soundslikefrank/eduquencer/hardware/README.md

# Eduquencer pcb schematic and design

## TODO

### Path to PCB prototype
- [ ] Finish the schematic
  - [x] Wire up rpi
  - [x] Add circuits for clock and reset
  - [x] Add debug header for flashing the rpi
  - [x] Add all the trigger jacks (+circuit around them, there might be some more resistors needed?)
  - [x] Add test-points for all i2c and SPI
  - [x] Check all GND in analog parts and change to GNDA (cv-in?)
  - [x] Annotate all parts
  - [x] Assign footprints (all footprints should be the kicad handsolder ones)
  - [ ] Add LED circuits for CV in (op-amps)
  - [ ] Adjust DAC opamp resistor for proper range (+add DAC out jack)
- [ ] Preliminary layout with all components (only footprint placement)
- [ ] Decide on a name
- [ ] Decide which jacks to use
- [ ] Do the final layout

## Preliminary BOM (per board)
- 1x RPI Pico (3,90)
- 3x https://www.digikey.de/de/products/detail/epcos-tdk-electronics/B72500D0160H060/1589537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 (1,5 @ 100)
- 1x GET AT JLC https://www.digikey.de/en/products/detail/texas-instruments/LM1117MP-5-0-NOPB/363590 (1,3 @ 25)
- 1x https://www.digikey.de/en/products/detail/analog-devices-inc/ADP150AUJZ-3-0-R7/2207488 (1 @ 25)
- 2x https://www.digikey.de/en/products/detail/microchip-technology/MCP23018-E-SS/1999506 (1,5 @ 25)
- 1x https://www.digikey.de/en/products/detail/texas-instruments/DAC80501MDGSR/11308813 (we probably want to get more) (5,6 @ 10)
- 2x 22u electrolytic cap (~0,5 total?)
- 9x XZM2CRK45WT-9 (red)
- 10x: XZDGK45WT-9 (green)
- 16x switches (~16 total?)
- 1x https://www.digikey.de/en/products/detail/texas-instruments/TL074CD/277422 (1 @ 25)
- 1x GET AT JLCPCB https://www.digikey.de/en/products/detail/microchip-technology/MCP6002-E-MS/683195 (0,4 @ 25)
- 1x https://www.digikey.com.au/en/products/detail/texas-instruments/OPA172IDR/4695363 (2,1 @ 25)
- 1x https://www.digikey.de/en/products/detail/texas-instruments/LM4040DIM3-10-0-NOPB/305141 (0,6 @ 25)
- 1x https://www.digikey.de/en/products/detail/texas-instruments/LM4040DIM3-5-0-NOPB/305140 (0,6 @ 25)
- 1x https://www.digikey.de/en/products/detail/panjit-international-inc/MMBT3904W-R1-00001/14660622 (0,15 @ 10)
- 3x GET AT JLC https://www.digikey.de/en/products/detail/diodes-incorporated/1N5819HWQ-7-F/10294862
- 1x GET AT JLC https://www.digikey.de/en/products/detail/panjit-international-inc/1N4148W-R1-00001/14660400
- 11x Thonkiconn (0,25 - I have ~300)
- 2x https://www.thonk.co.uk/shop/short-trimmer-pots/ B100K (0,8)

### LEDs
- MCP capabilities: 25mA sink per pin, 400mA total
- RPI capabilities: 3V3 is the main 3.3V supply to RP2040 and its I/O, generated by the on-board SMPS. This pin can be used to power external circuitry (maximum output current will depend on RP2040 load and VSYS voltage, it is recommended to keep the load on this pin less than 300mA).
- Step/channel LEDs:
  - Green: XZDGK45WT-9; 1.4mA@560Ω@3v3
  - Red: XZM2CRK45WT-9; 6.3mA@220Ω@3v3
