soundslikefrank/eduquencer/design/footprint/.svg2shenzhen-cache/images/B.Cu_layer2.png

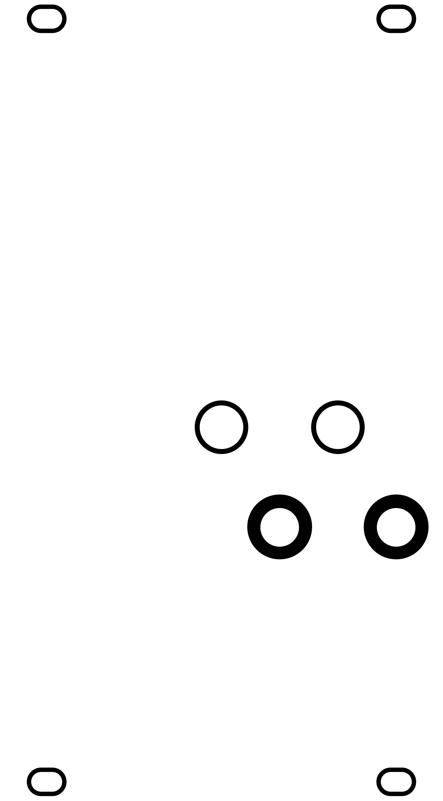
design/footprint/.svg2shenzhen-cache/images/B.Cu_layer2.png
