soundslikefrank/eduquencer/design/footprint/.svg2shenzhen-cache/images/B.Mask_layer1.png

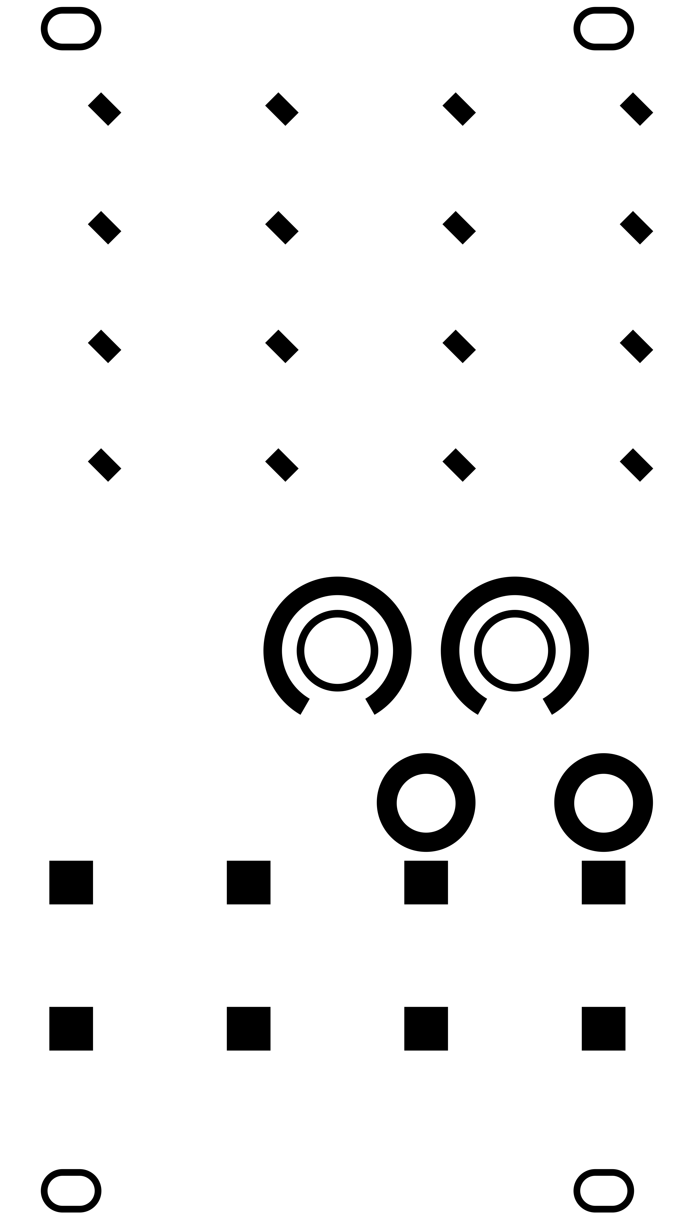
design/footprint/.svg2shenzhen-cache/images/B.Mask_layer1.png
