soundslikefrank/eduquencer/design/footprint/.svg2shenzhen-cache/images/Eco1.User_g74.png

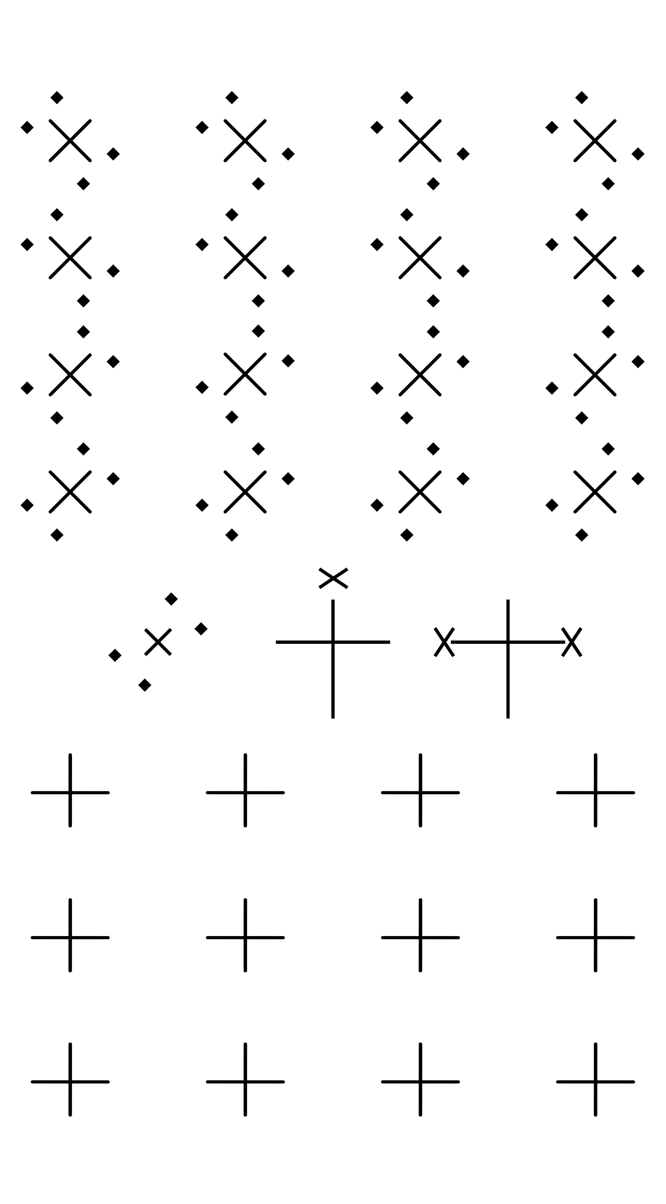
design/footprint/.svg2shenzhen-cache/images/Eco1.User_g74.png
