soundslikefrank/eduquencer/design/footprint/.svg2shenzhen-cache/images/F.Cu_g21.png

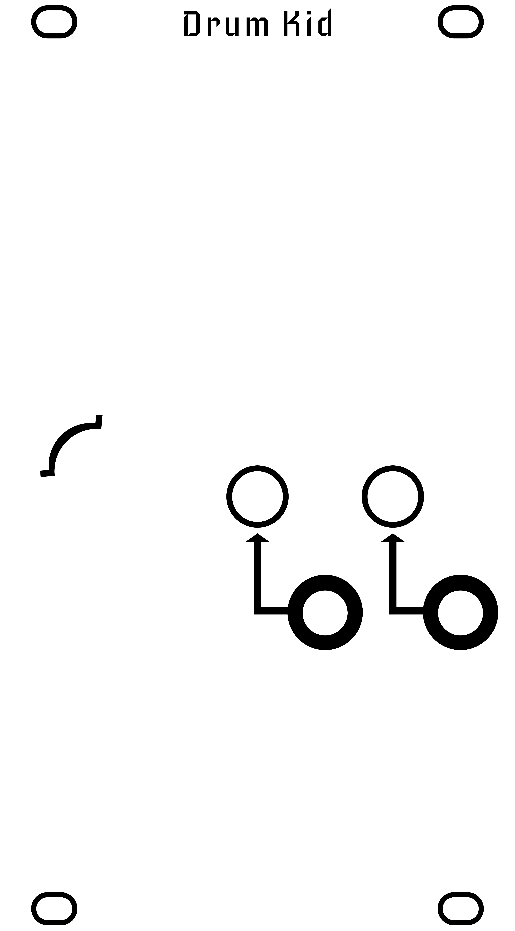
design/footprint/.svg2shenzhen-cache/images/F.Cu_g21.png
