soundslikefrank/eduquencer/design/footprint/.svg2shenzhen-cache/images/F.Mask_g23.png

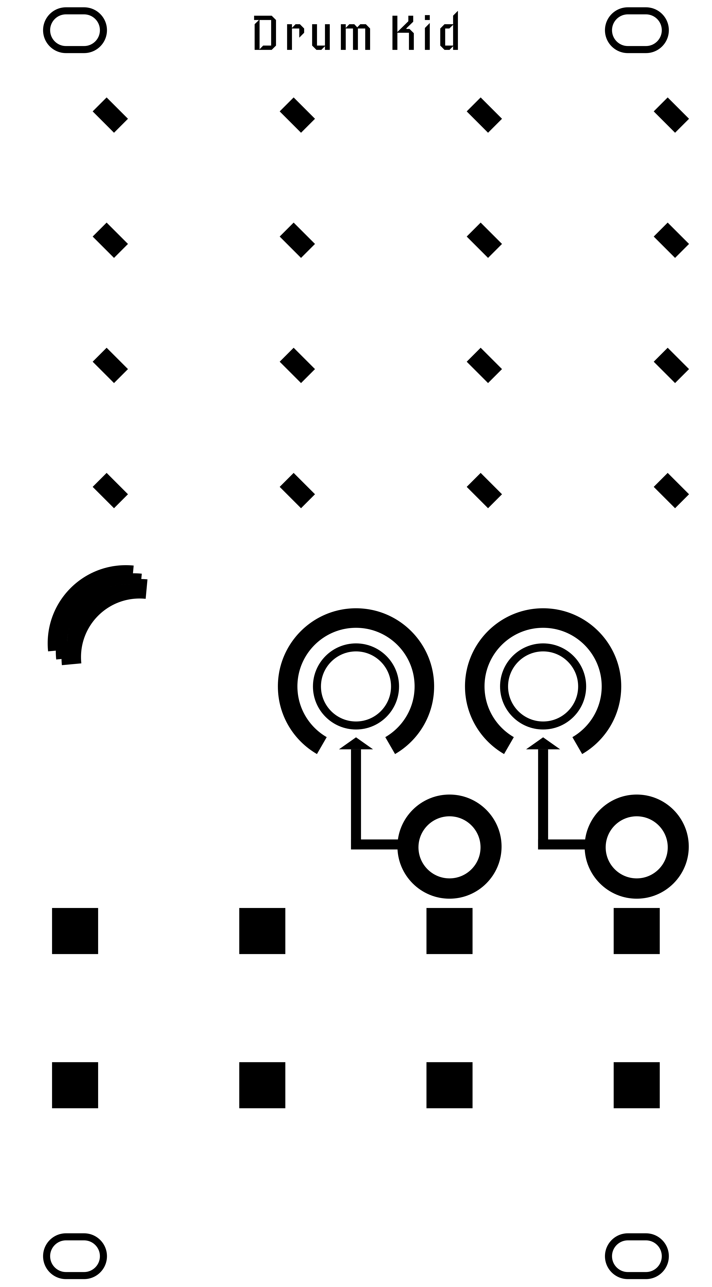
design/footprint/.svg2shenzhen-cache/images/F.Mask_g23.png
