soundslikefrank/eduquencer/design/footprint/.svg2shenzhen-cache/images/F.SilkS_g25.png

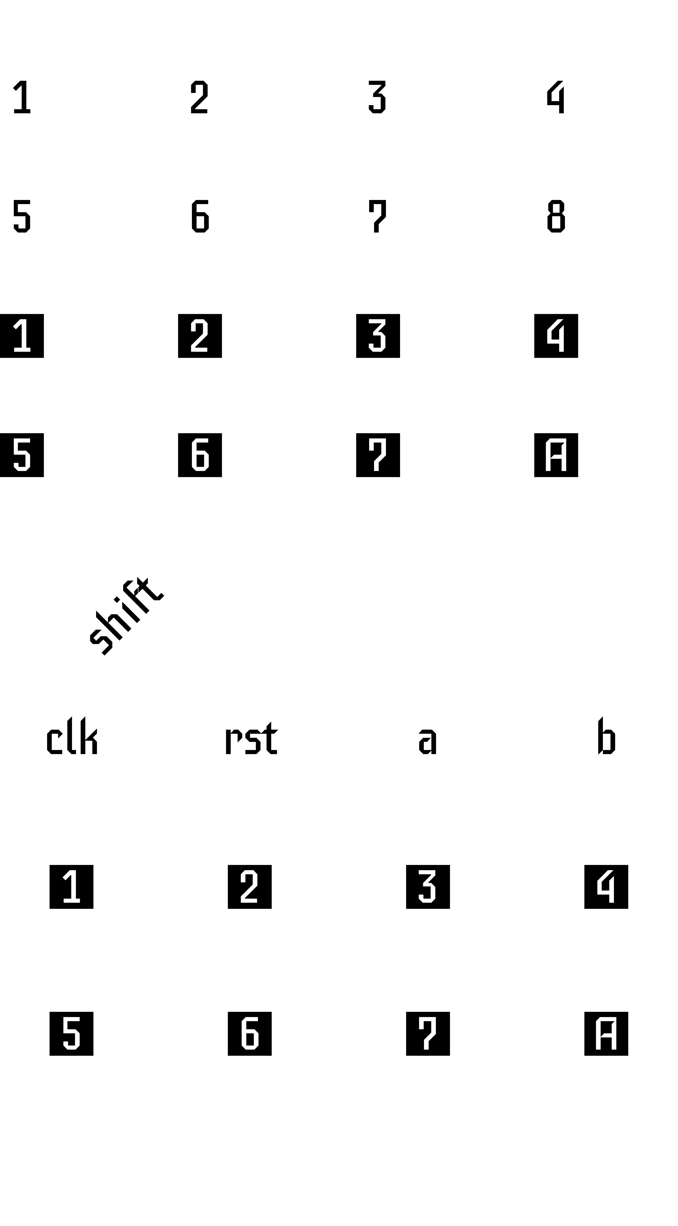
design/footprint/.svg2shenzhen-cache/images/F.SilkS_g25.png
