soundslikefrank/eduquencer/design/RD901F-40-15R1.amf

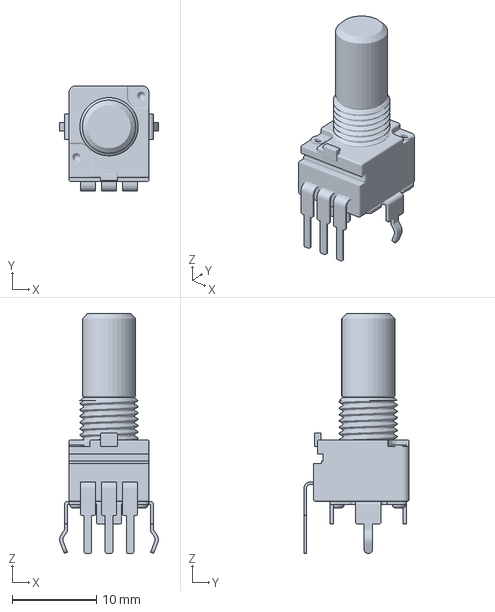
[picture p7: CAD file, 2022-02-01]
design/RD901F-40-15R1.amf
11.7 x 12.5 x 28.5 mm
