soundslikefrank/eduquencer/design/WQP-PJ398SM.amf

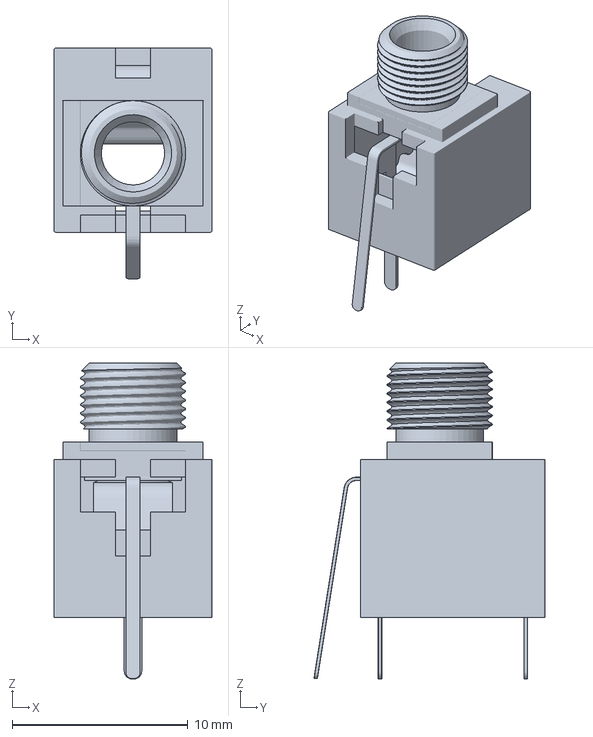
[picture p8: CAD file, 2022-02-01]
design/WQP-PJ398SM.amf
9.00 x 13.2 x 18.0 mm
