soundslikefrank/eduquencer/design/CUI_DEVICES_TS04-66-73-BK-100-SMT.STL

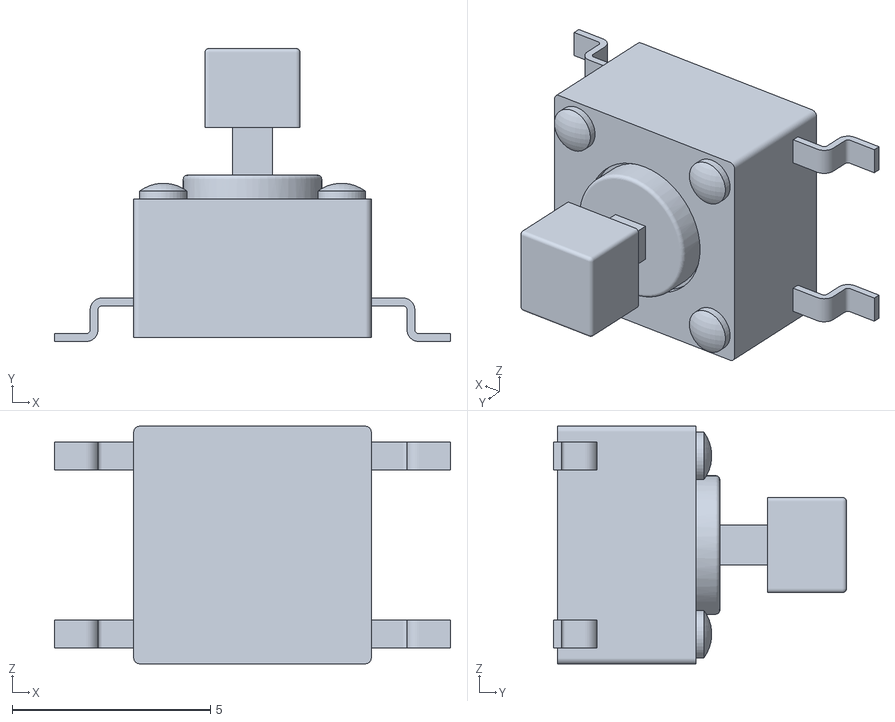
[picture p9: CAD file, 2022-02-01]
design/CUI_DEVICES_TS04-66-73-BK-100-SMT.STL
10.0 x 7.40 x 6.00
