soundslikefrank/eduquencer/hardware/eduquencer/eduquencer.kicad_pcb

## KiCad design hardware/eduquencer/eduquencer.kicad_pcb (2022-03-17)

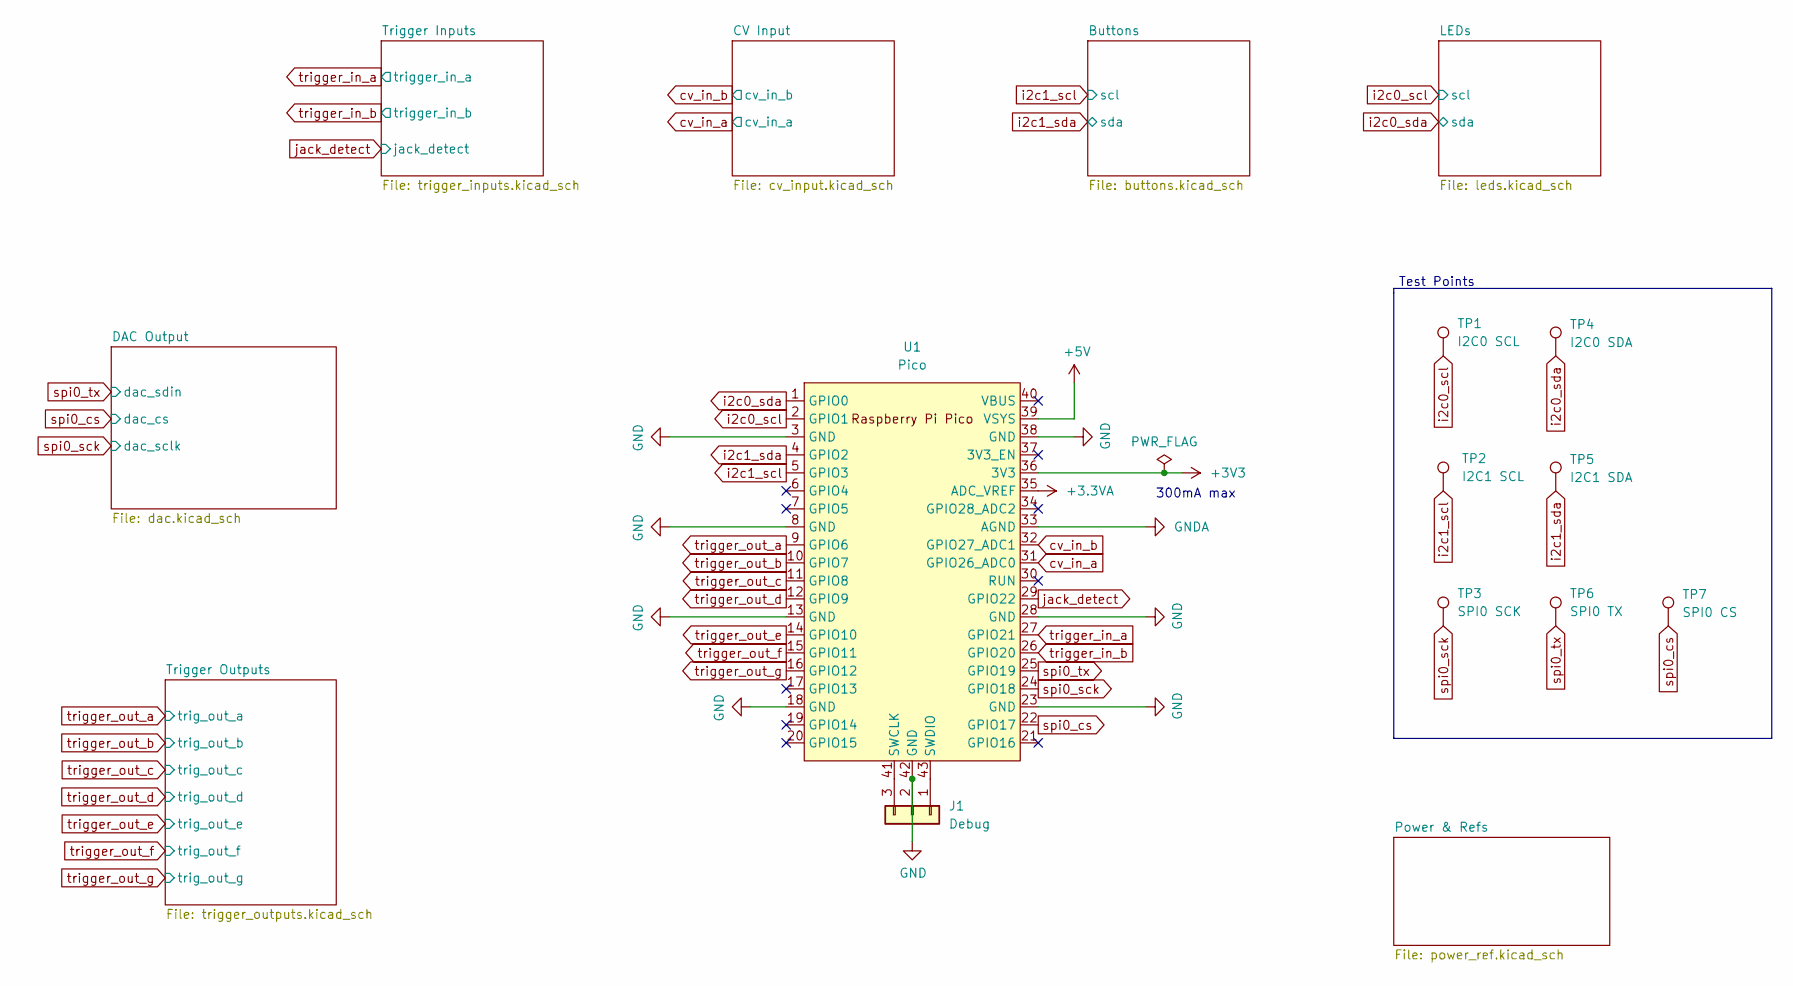
[picture p10: schematic eduquencer.kicad_sch]

Parts:
J1: Debug; PinHeader_1x03_P2.54mm_Vertical
TP1: I2C0 SCL; TestPoint_Pad_2.0x2.0mm
TP2: I2C1 SCL; TestPoint_Pad_2.0x2.0mm
TP3: SPI0 SCK; TestPoint_Pad_2.0x2.0mm
TP4: I2C0 SDA; TestPoint_Pad_2.0x2.0mm
TP5: I2C1 SDA; TestPoint_Pad_2.0x2.0mm
TP6: SPI0 TX; TestPoint_Pad_2.0x2.0mm
TP7: SPI0 CS; TestPoint_Pad_2.0x2.0mm
U1: Pico; RPi_Pico_SMD_TH

Connections:
+3.3VA: U1.35 (ADC_VREF); also elsewhere on the board
+5V: U1.39 (VSYS); also elsewhere on the board
GND: J1.2, U1.3 (GND), U1.8 (GND), U1.13 (GND), U1.18 (GND), U1.23 (GND), U1.28 (GND), U1.38 (GND), U1.42 (GND); also elsewhere on the board
GNDA: U1.33 (AGND); also elsewhere on the board
unnamed: J1.1, U1.43 (SWDIO)
unnamed: J1.3, U1.41 (SWCLK)
cv_in_a: U1.31 (GPIO26_ADC0); also elsewhere on the board
cv_in_b: U1.32 (GPIO27_ADC1); also elsewhere on the board
i2c0_scl: TP1.1, U1.2 (GPIO1); also elsewhere on the board
i2c0_sda: TP4.1, U1.1 (GPIO0); also elsewhere on the board
i2c1_scl: TP2.1, U1.5 (GPIO3); also elsewhere on the board
i2c1_sda: TP5.1, U1.4 (GPIO2); also elsewhere on the board
jack_detect: U1.29 (GPIO22); also elsewhere on the board
spi0_cs: TP7.1, U1.22 (GPIO17); also elsewhere on the board
spi0_sck: TP3.1, U1.24 (GPIO18); also elsewhere on the board
spi0_tx: TP6.1, U1.25 (GPIO19); also elsewhere on the board
trigger_in_a: U1.27 (GPIO21); also elsewhere on the board
trigger_in_b: U1.26 (GPIO20); also elsewhere on the board
trigger_out_a: U1.9 (GPIO6); also elsewhere on the board
trigger_out_b: U1.10 (GPIO7); also elsewhere on the board
trigger_out_c: U1.11 (GPIO8); also elsewhere on the board
trigger_out_d: U1.12 (GPIO9); also elsewhere on the board
trigger_out_e: U1.14 (GPIO10); also elsewhere on the board
trigger_out_f: U1.15 (GPIO11); also elsewhere on the board
trigger_out_g: U1.16 (GPIO12); also elsewhere on the board

Notes on the sheet:
300mA max
Test Points

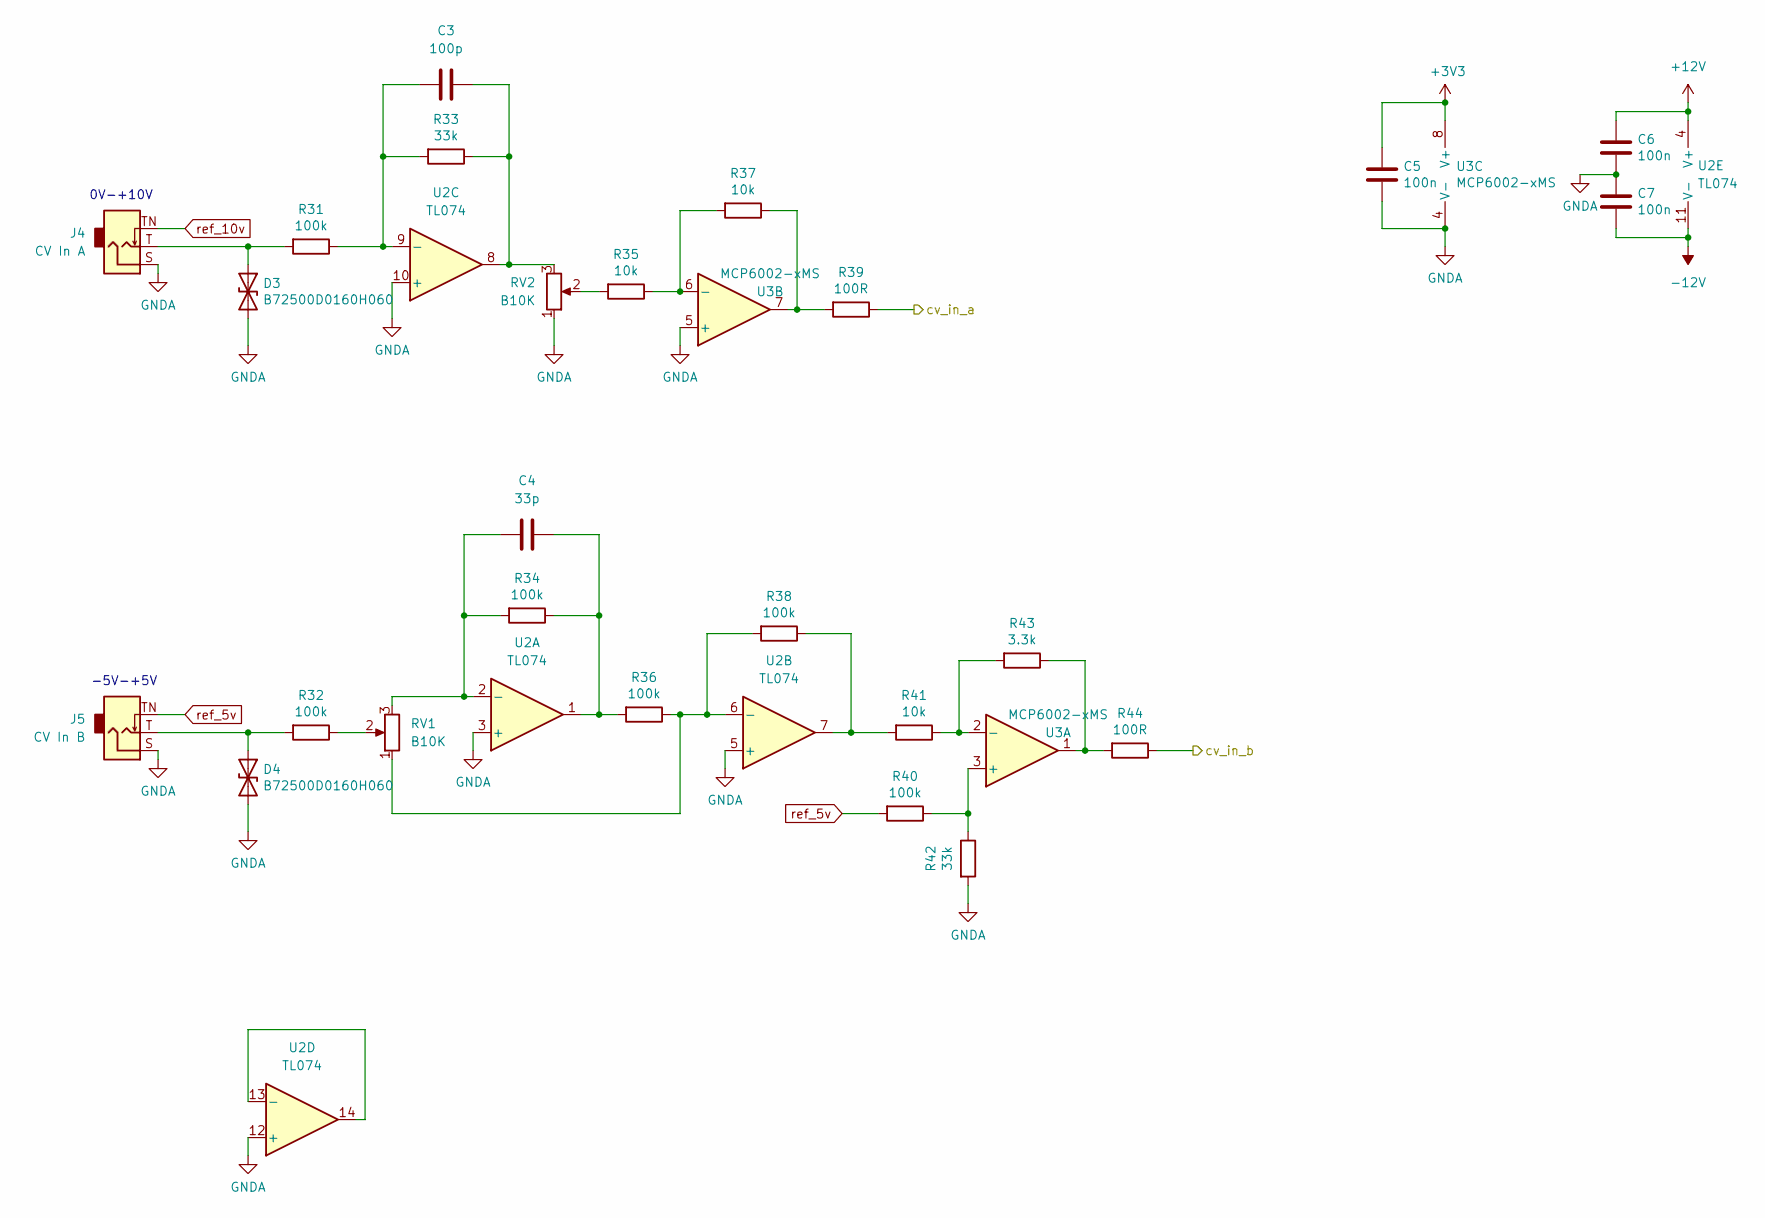
[picture p11: schematic cv_input.kicad_sch]

Parts:
C3: 100p; C_0603_1608Metric_Pad1.08x0.95mm_HandSolder
C4: 33p; C_0603_1608Metric_Pad1.08x0.95mm_HandSolder
C5, C6, C7: 100n; C_0603_1608Metric_Pad1.08x0.95mm_HandSolder
D3, D4: B72500D0160H060; D_0603_1608Metric_Pad1.05x0.95mm_HandSolder
J4: CV In A; Jack_3.5mm_QingPu_WQP-PJ301BM_Vertical
J5: CV In B; Jack_3.5mm_QingPu_WQP-PJ301BM_Vertical
R31, R32, R34, R36, R38, R40: 100k; R_0603_1608Metric_Pad0.98x0.95mm_HandSolder
R33, R42: 33k; R_0603_1608Metric_Pad0.98x0.95mm_HandSolder
R35, R37, R41: 10k; R_0603_1608Metric_Pad0.98x0.95mm_HandSolder
R39, R44: 100R; R_0603_1608Metric_Pad0.98x0.95mm_HandSolder
R43: 3.3k; R_0603_1608Metric_Pad0.98x0.95mm_HandSolder
RV1, RV2: B10K; Potentiometer_Alpha_RD901F-40-00D_Single_Vertical
U2: TL074; SOIC-14_3.9x8.7mm_P1.27mm
U3: MCP6002-xMS; SOIC-8_3.9x4.9mm_P1.27mm

Connections:
+12V: C6.1, U2.4 (V+); also elsewhere on the board
-12V: C7.2, U2.11 (V-); also elsewhere on the board
GNDA: C5.2, C6.2, C7.1, D3.2 (A2), D4.2 (A2), J4.S, J5.S, R42.2, RV2.1, U2.3 (+), U2.5 (+), U2.10 (+), U2.12 (+), U3.4 (V-), U3.5 (+); also elsewhere on the board
unnamed: C3.1, R31.1, R33.2, U2.9 (-)
unnamed: C3.2, R33.1, RV2.3, U2.8
unnamed: C4.1, R34.2, RV1.3, U2.2 (-)
unnamed: C4.2, R34.1, R36.2, U2.1
unnamed: D3.1 (A1), J4.T, R31.2
unnamed: D4.1 (A1), J5.T, R32.2
unnamed: R32.1, RV1.2
unnamed: R35.1, R37.2, U3.6 (-)
unnamed: R35.2, RV2.2
unnamed: R36.1, R38.2, RV1.1, U2.6 (-)
unnamed: R37.1, R39.2, U3.7
unnamed: R38.1, R41.2, U2.7
unnamed: R40.1, R42.1, U3.3 (+)
unnamed: R41.1, R43.2, U3.2 (-)
unnamed: R43.1, R44.2, U3.1
unnamed: U2.13 (-), U2.14
cv_in_a: R39.1; also elsewhere on the board
cv_in_b: R44.1; also elsewhere on the board
ref_5v: J5.TN, R40.2; also elsewhere on the board
ref_10v: J4.TN; also elsewhere on the board

Notes on the sheet:
0V-+10V
-5V-+5V

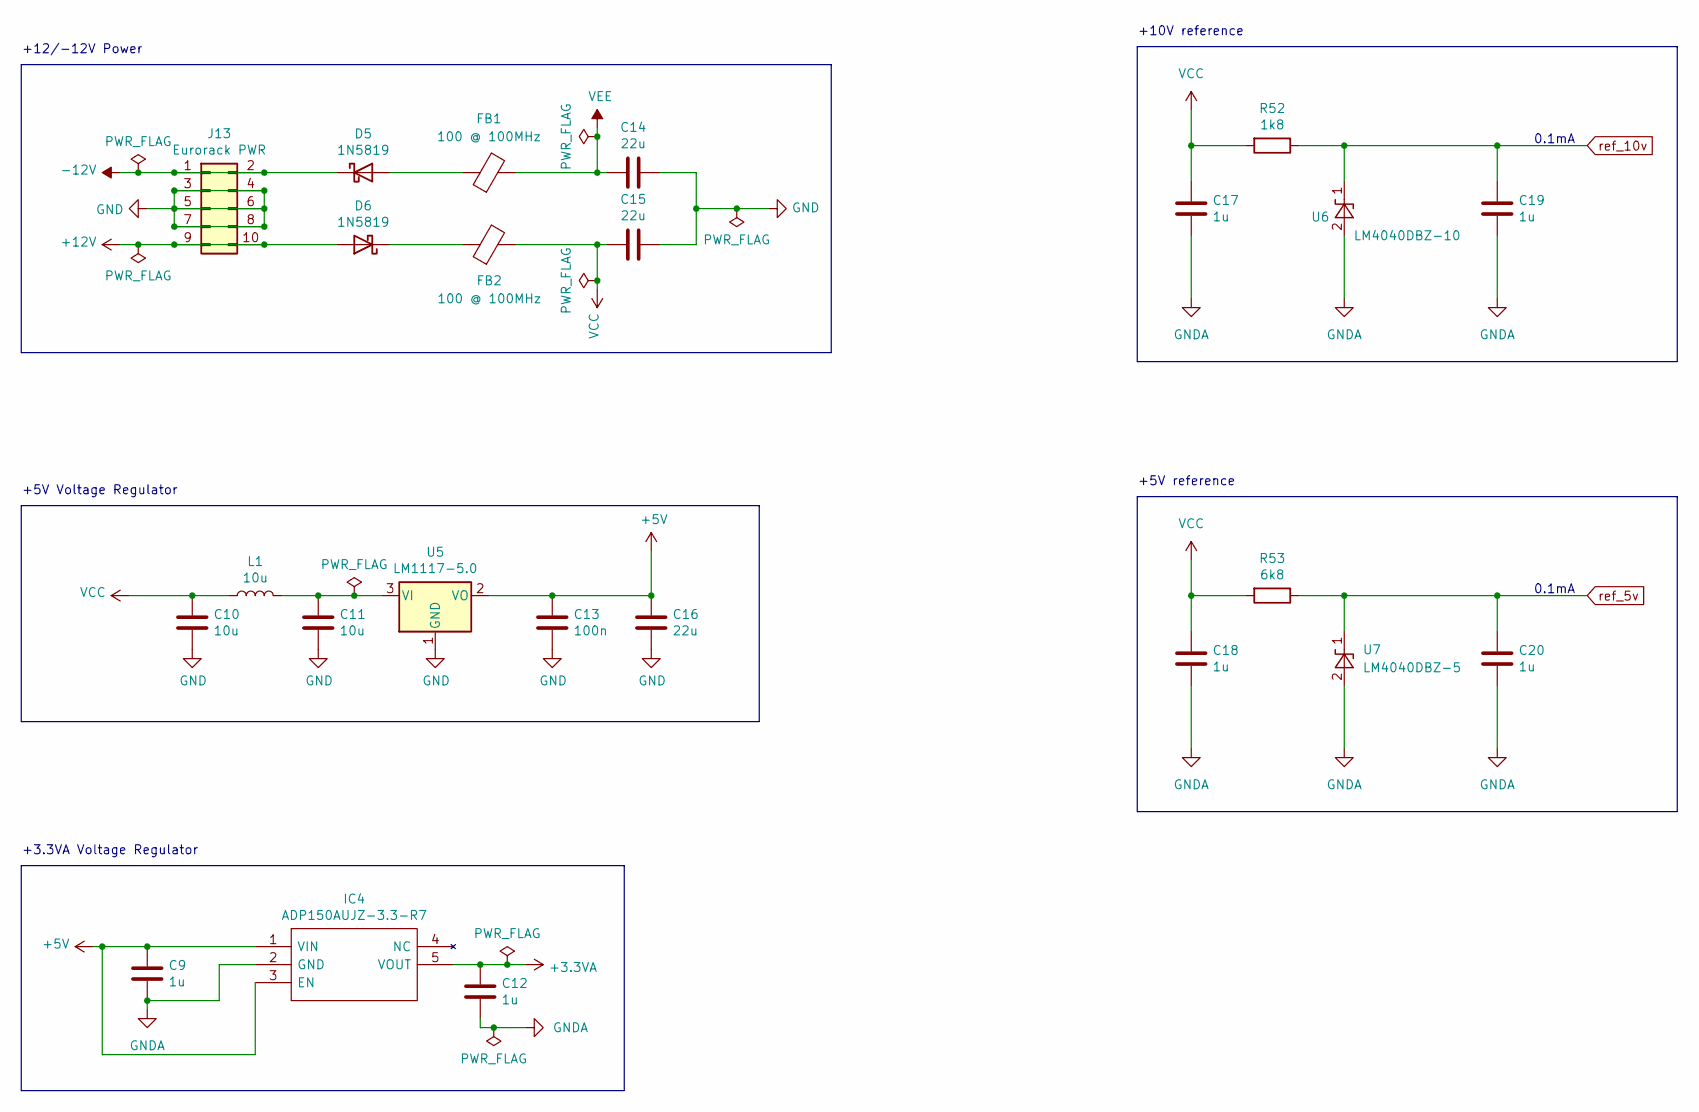
[picture p12: schematic power_ref.kicad_sch]

Parts:
C9, C12, C17, C18, C19, C20: 1u; C_0603_1608Metric_Pad1.08x0.95mm_HandSolder
C10, C11: 10u; C_0805_2012Metric_Pad1.18x1.45mm_HandSolder
C13: 100n; C_0603_1608Metric_Pad1.08x0.95mm_HandSolder
C14, C15: 22u; CP_Elec_5x5.3
C16: 22u; C_0805_2012Metric_Pad1.18x1.45mm_HandSolder
D5, D6: 1N5819; D_SOD-123
FB1, FB2: 100 @ 100MHz; L_0805_2012Metric_Pad1.05x1.20mm_HandSolder
IC4: ADP150AUJZ-3.3-R7; SOT95P280X100-5N; Manufacturer_Part_Number ADP150AUJZ-3.3-R7; Mouser Part Number 584-ADP150AUJZ-3.3R7
J13: Eurorack PWR; PinHeader_2x05_P2.54mm_Vertical_SMD
L1: 10u; L_0805_2012Metric_Pad1.05x1.20mm_HandSolder
R52: 1k8; R_0603_1608Metric_Pad0.98x0.95mm_HandSolder
R53: 6k8; R_0603_1608Metric_Pad0.98x0.95mm_HandSolder
U5: LM1117-5.0; SOT-223
U6: LM4040DBZ-10; SOT-23_Handsoldering
U7: LM4040DBZ-5; SOT-23_Handsoldering

Connections:
+3.3VA: C12.1, IC4.5 (VOUT); also elsewhere on the board
+5V: C9.1, C13.1, C16.2, IC4.1 (VIN), IC4.3 (EN), U5.2 (VO); also elsewhere on the board
+12V: D6.2 (A), J13.9, J13.10; also elsewhere on the board
-12V: D5.1 (K), J13.1, J13.2; also elsewhere on the board
GND: C10.2, C11.1, C13.2, C14.1, C15.1, C16.1, J13.3, J13.4, J13.5, J13.6, J13.7, J13.8, U5.1 (GND); also elsewhere on the board
GNDA: C9.2, C12.2, C17.2, C18.2, C19.2, C20.2, IC4.2 (GND), U6.2 (A), U7.2 (A); also elsewhere on the board
unnamed: C11.2, L1.2, U5.3 (VI)
unnamed: D5.2 (A), FB1.1
unnamed: D6.1 (K), FB2.1
VCC: C10.1, C15.2, C17.1, C18.1, FB2.2, L1.1, R52.2, R53.2; also elsewhere on the board
VEE: C14.2, FB1.2; also elsewhere on the board
ref_5v: C20.1, R53.1, U7.1 (K); also elsewhere on the board
ref_10v: C19.1, R52.1, U6.1 (K); also elsewhere on the board

Notes on the sheet:
+5V Voltage Regulator
0.1mA
+3.3VA Voltage Regulator
+12/-12V Power
+10V reference
+5V reference

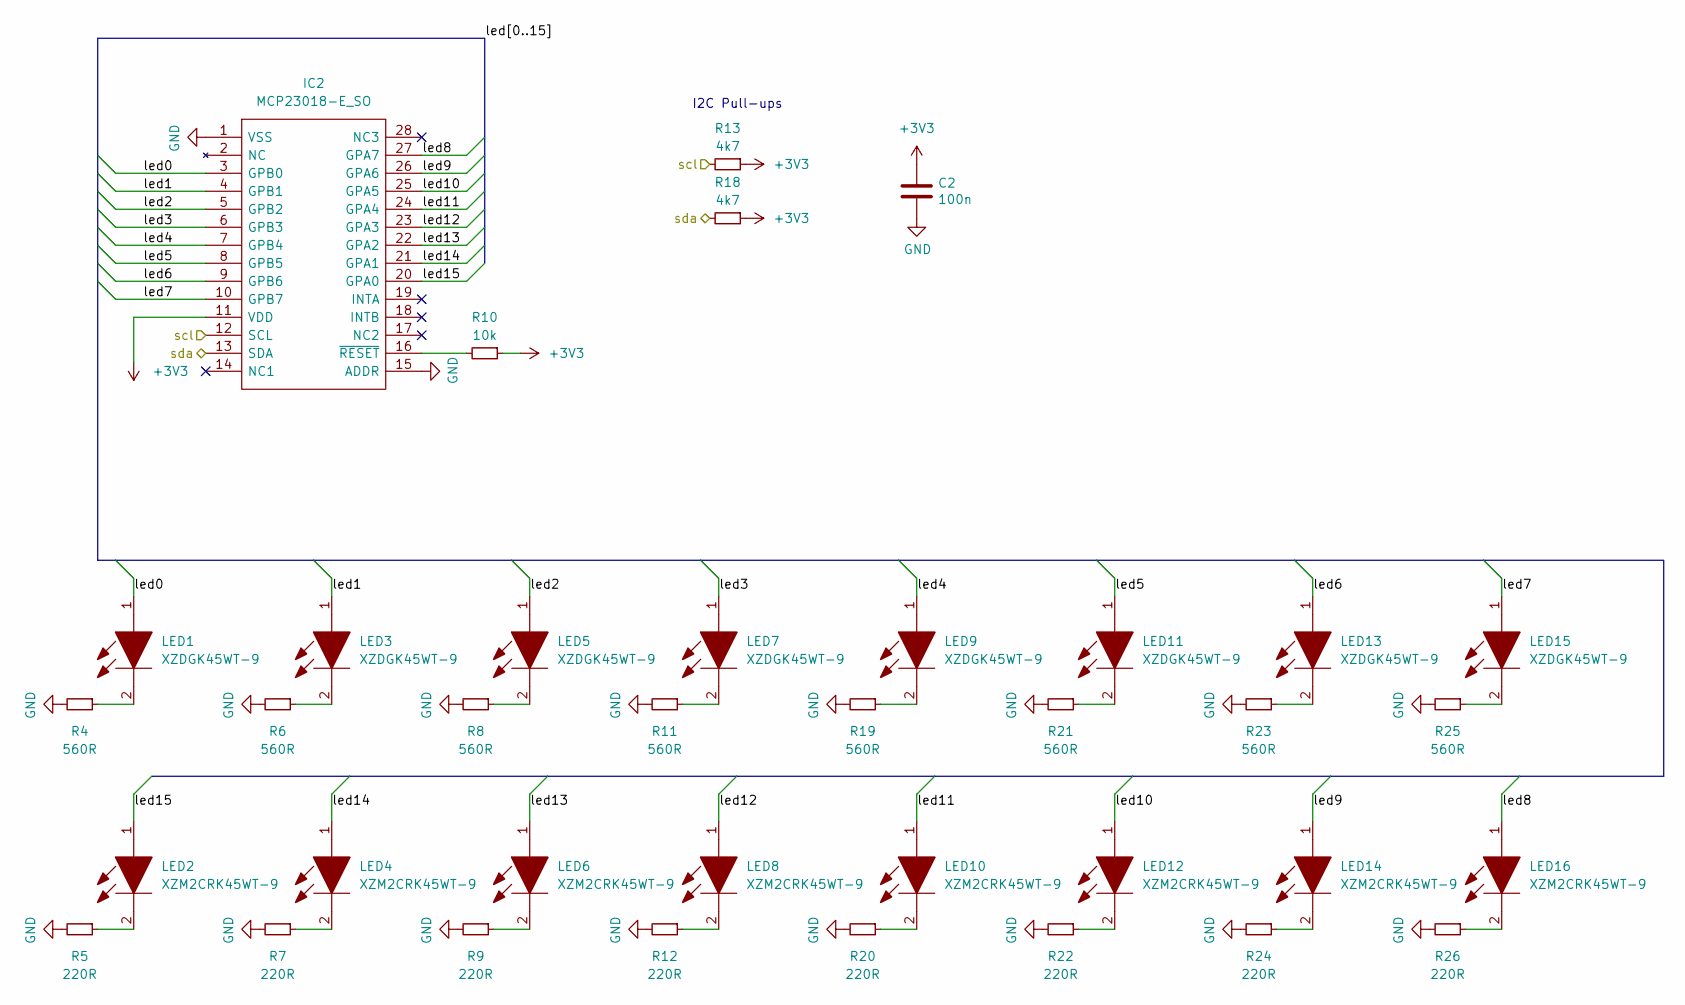
[picture p13: schematic leds.kicad_sch]

Parts:
C2: 100n; C_0603_1608Metric_Pad1.08x0.95mm_HandSolder
IC2: MCP23018-E_SO; SOIC127P1030X265-28N; Manufacturer_Part_Number MCP23018-E/SO; Mouser Part Number 579-MCP23018-E/SO
LED1, LED3, LED5, LED7, LED9, LED11, LED13, LED15: XZDGK45WT-9; XZMYK45WT9; Manufacturer_Part_Number XZMYK45WT-9
LED2, LED4, LED6, LED8, LED10, LED12, LED14, LED16: XZM2CRK45WT-9; XZMYK45WT9; Manufacturer_Part_Number XZMYK45WT-9
R4, R6, R8, R11, R19, R21, R23, R25: 560R; R_0603_1608Metric_Pad0.98x0.95mm_HandSolder
R5, R7, R9, R12, R20, R22, R24, R26: 220R; R_0603_1608Metric_Pad0.98x0.95mm_HandSolder
R10: 10k; R_0603_1608Metric_Pad0.98x0.95mm_HandSolder
R13, R18: 4k7; R_0603_1608Metric_Pad0.98x0.95mm_HandSolder

Connections:
/LEDs/led0: IC2.3 (GPB0), LED1.1
/LEDs/led1: IC2.4 (GPB1), LED3.1
/LEDs/led2: IC2.5 (GPB2), LED5.1
/LEDs/led3: IC2.6 (GPB3), LED7.1
/LEDs/led4: IC2.7 (GPB4), LED9.1
/LEDs/led5: IC2.8 (GPB5), LED11.1
/LEDs/led6: IC2.9 (GPB6), LED13.1
/LEDs/led7: IC2.10 (GPB7), LED15.1
/LEDs/led8: IC2.27 (GPA7), LED16.1
/LEDs/led9: IC2.26 (GPA6), LED14.1
/LEDs/led10: IC2.25 (GPA5), LED12.1
/LEDs/led11: IC2.24 (GPA4), LED10.1
/LEDs/led12: IC2.23 (GPA3), LED8.1
/LEDs/led13: IC2.22 (GPA2), LED6.1
/LEDs/led14: IC2.21 (GPA1), LED4.1
/LEDs/led15: IC2.20 (GPA0), LED2.1
GND: C2.2, IC2.1 (VSS), IC2.15 (ADDR), R4.2, R5.2, R6.2, R7.2, R8.2, R9.2, R11.2, R12.2, R19.2, R20.2, R21.2, R22.2, R23.2, R24.2, R25.2, R26.2; also elsewhere on the board
unnamed: IC2.16 (~RESET), R10.2
unnamed: LED1.2, R4.1
unnamed: LED2.2, R5.1
unnamed: LED3.2, R6.1
unnamed: LED4.2, R7.1
unnamed: LED5.2, R8.1
unnamed: LED6.2, R9.1
unnamed: LED7.2, R11.1
unnamed: LED8.2, R12.1
unnamed: LED9.2, R19.1
unnamed: LED10.2, R20.1
unnamed: LED11.2, R21.1
unnamed: LED12.2, R22.1
unnamed: LED13.2, R23.1
unnamed: LED14.2, R24.1
unnamed: LED15.2, R25.1
unnamed: LED16.2, R26.1
i2c0_scl: IC2.12 (SCL), R13.2; also elsewhere on the board
i2c0_sda: IC2.13 (SDA), R18.2; also elsewhere on the board

Notes on the sheet:
I2C Pull-ups

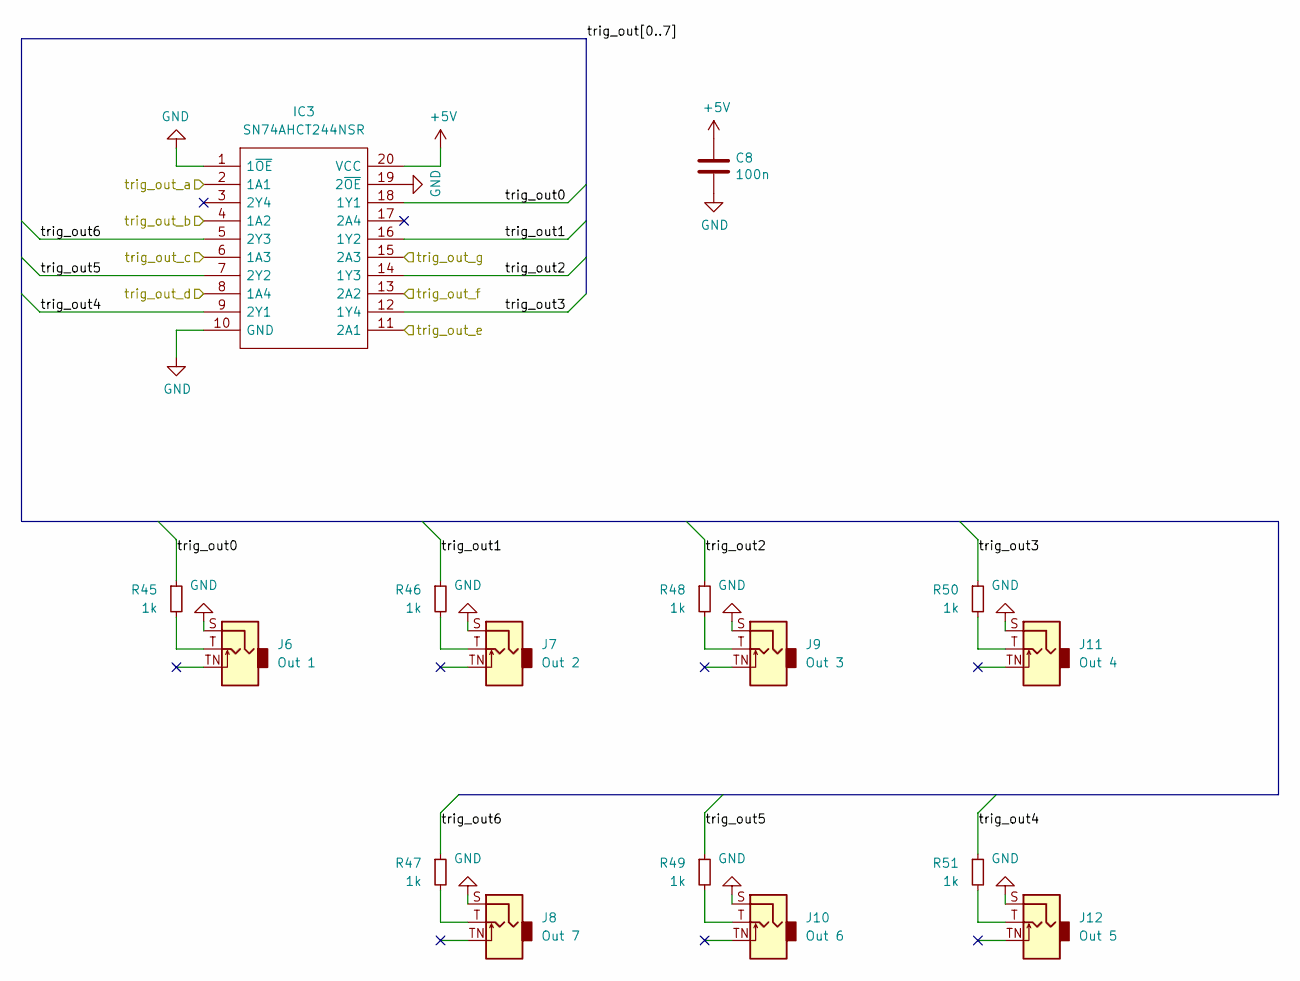
[picture p14: schematic trigger_outputs.kicad_sch]

Parts:
C8: 100n; C_0603_1608Metric_Pad1.08x0.95mm_HandSolder
IC3: SN74AHCT244NSR; SOIC127P780X200-20N; Manufacturer_Part_Number SN74AHCT244NSR; Mouser Part Number 595-SN74AHCT244NSR
J6: Out 1; Jack_3.5mm_QingPu_WQP-PJ301BM_Vertical
J7: Out 2; Jack_3.5mm_QingPu_WQP-PJ301BM_Vertical
J8: Out 7; Jack_3.5mm_QingPu_WQP-PJ301BM_Vertical
J9: Out 3; Jack_3.5mm_QingPu_WQP-PJ301BM_Vertical
J10: Out 6; Jack_3.5mm_QingPu_WQP-PJ301BM_Vertical
J11: Out 4; Jack_3.5mm_QingPu_WQP-PJ301BM_Vertical
J12: Out 5; Jack_3.5mm_QingPu_WQP-PJ301BM_Vertical
R45, R46, R47, R48, R49, R50, R51: 1k; R_0603_1608Metric_Pad0.98x0.95mm_HandSolder

Connections:
+5V: C8.1, IC3.20 (VCC); also elsewhere on the board
/Trigger Outputs/trig_out0: IC3.18 (1Y1), R45.1
/Trigger Outputs/trig_out1: IC3.16 (1Y2), R46.1
/Trigger Outputs/trig_out2: IC3.14 (1Y3), R48.1
/Trigger Outputs/trig_out3: IC3.12 (1Y4), R50.1
/Trigger Outputs/trig_out4: IC3.9 (2Y1), R51.1
/Trigger Outputs/trig_out5: IC3.7 (2Y2), R49.1
/Trigger Outputs/trig_out6: IC3.5 (2Y3), R47.1
GND: C8.2, IC3.1 (1~OE), IC3.10 (GND), IC3.19 (2~OE), J6.S, J7.S, J8.S, J9.S, J10.S, J11.S, J12.S; also elsewhere on the board
unnamed: J6.T, R45.2
unnamed: J7.T, R46.2
unnamed: J8.T, R47.2
unnamed: J9.T, R48.2
unnamed: J10.T, R49.2
unnamed: J11.T, R50.2
unnamed: J12.T, R51.2
trigger_out_a: IC3.2 (1A1); also elsewhere on the board
trigger_out_b: IC3.4 (1A2); also elsewhere on the board
trigger_out_c: IC3.6 (1A3); also elsewhere on the board
trigger_out_d: IC3.8 (1A4); also elsewhere on the board
trigger_out_e: IC3.11 (2A1); also elsewhere on the board
trigger_out_f: IC3.13 (2A2); also elsewhere on the board
trigger_out_g: IC3.15 (2A3); also elsewhere on the board

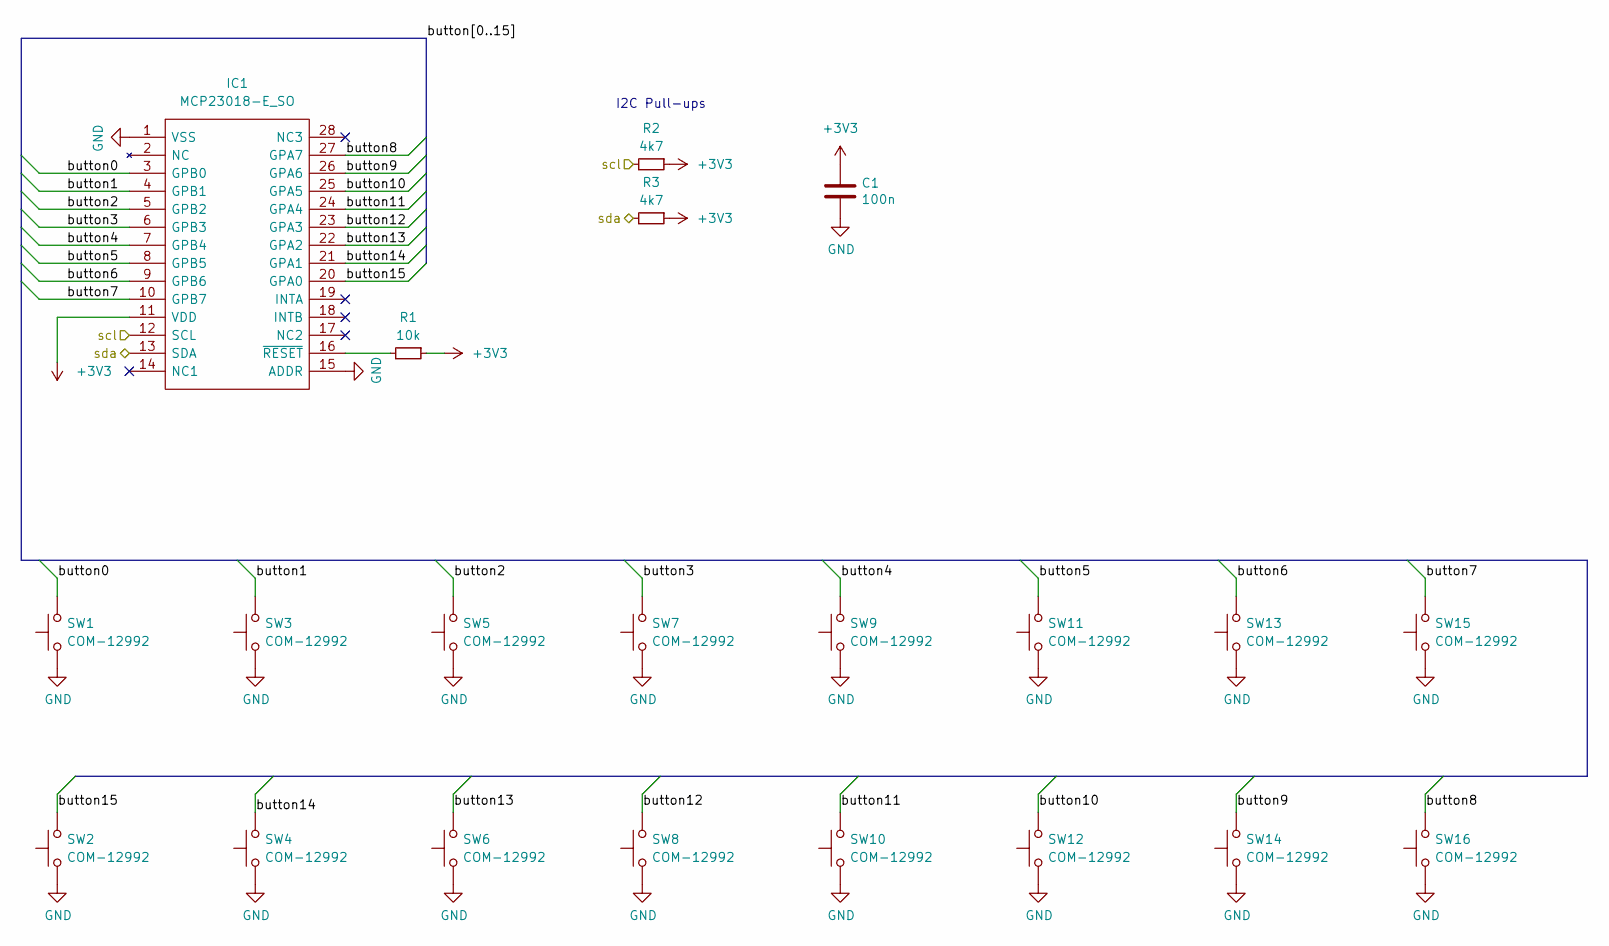
[picture p15: schematic buttons.kicad_sch]

Parts:
C1: 100n; C_0603_1608Metric_Pad1.08x0.95mm_HandSolder
IC1: MCP23018-E_SO; SOIC127P1030X265-28N; Manufacturer_Part_Number MCP23018-E/SO; Mouser Part Number 579-MCP23018-E/SO
R1: 10k; R_0603_1608Metric_Pad0.98x0.95mm_HandSolder
R2, R3: 4k7; R_0603_1608Metric_Pad0.98x0.95mm_HandSolder
SW1, SW2, SW3, SW4, SW5, SW6, SW7, SW8, SW9, SW10, SW11, SW12, SW13, SW14, SW15, SW16: COM-12992; SW_Push_1P1T_NO_6x6mm_H9.5mm

Connections:
/Buttons/button0: IC1.3 (GPB0), SW1.2
/Buttons/button1: IC1.4 (GPB1), SW3.2
/Buttons/button2: IC1.5 (GPB2), SW5.2
/Buttons/button3: IC1.6 (GPB3), SW7.2
/Buttons/button4: IC1.7 (GPB4), SW9.2
/Buttons/button5: IC1.8 (GPB5), SW11.2
/Buttons/button6: IC1.9 (GPB6), SW13.2
/Buttons/button7: IC1.10 (GPB7), SW15.2
/Buttons/button8: IC1.27 (GPA7), SW16.2
/Buttons/button9: IC1.26 (GPA6), SW14.2
/Buttons/button10: IC1.25 (GPA5), SW12.2
/Buttons/button11: IC1.24 (GPA4), SW10.2
/Buttons/button12: IC1.23 (GPA3), SW8.2
/Buttons/button13: IC1.22 (GPA2), SW6.2
/Buttons/button14: IC1.21 (GPA1), SW4.2
/Buttons/button15: IC1.20 (GPA0), SW2.2
GND: C1.2, IC1.1 (VSS), IC1.15 (ADDR), SW1.1, SW2.1, SW3.1, SW4.1, SW5.1, SW6.1, SW7.1, SW8.1, SW9.1, SW10.1, SW11.1, SW12.1, SW13.1, SW14.1, SW15.1, SW16.1; also elsewhere on the board
unnamed: IC1.16 (~RESET), R1.2
i2c1_scl: IC1.12 (SCL), R2.2; also elsewhere on the board
i2c1_sda: IC1.13 (SDA), R3.2; also elsewhere on the board

Notes on the sheet:
I2C Pull-ups

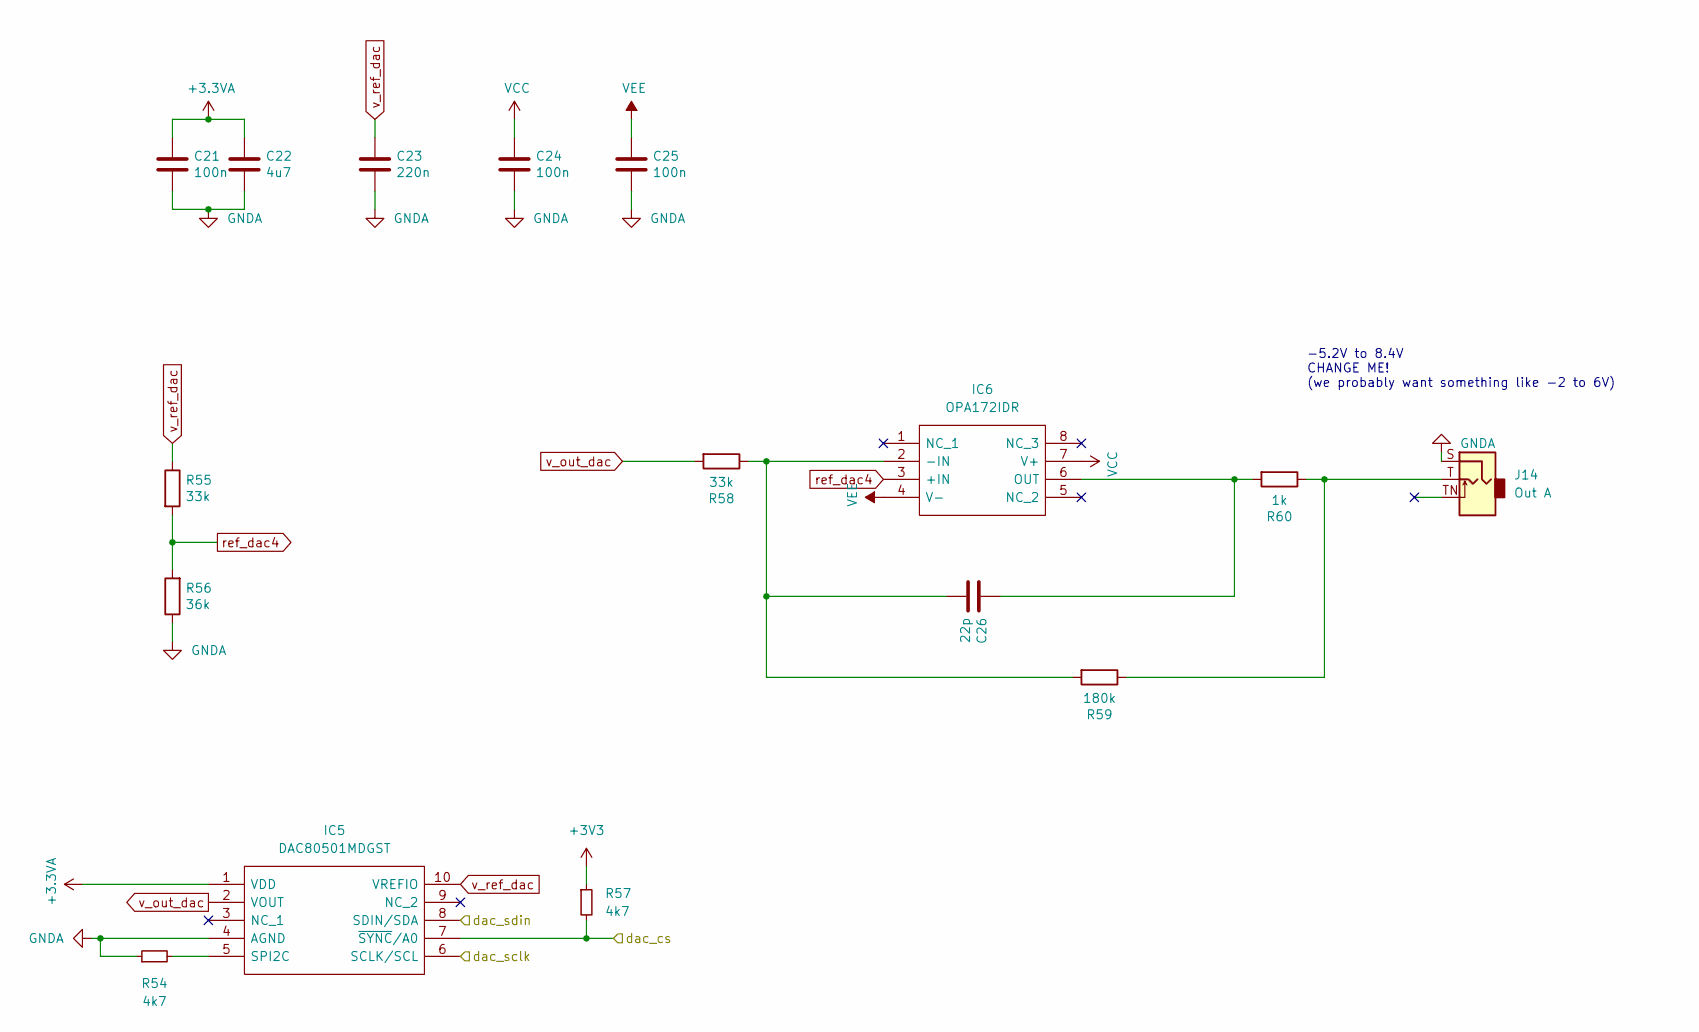
[picture p16: schematic dac.kicad_sch]

Parts:
C21, C24, C25: 100n; C_0603_1608Metric_Pad1.08x0.95mm_HandSolder
C22: 4u7; C_0603_1608Metric_Pad1.08x0.95mm_HandSolder
C23: 220n; C_0603_1608Metric_Pad1.08x0.95mm_HandSolder
C26: 22p; C_0603_1608Metric_Pad1.08x0.95mm_HandSolder
IC5: DAC80501MDGST; SOP50P490X110-10N; Manufacturer_Part_Number DAC80501MDGST; Mouser Part Number 595-DAC80501MDGST
IC6: OPA172IDR; SOIC127P600X175-8N; Manufacturer_Part_Number OPA172IDR; Mouser Part Number 595-OPA172IDR
J14: Out A; Jack_3.5mm_QingPu_WQP-PJ301BM_Vertical
R54, R57: 4k7; R_0603_1608Metric_Pad0.98x0.95mm_HandSolder
R55, R58: 33k; R_0603_1608Metric_Pad0.98x0.95mm_HandSolder
R56: 36k; R_0603_1608Metric_Pad0.98x0.95mm_HandSolder
R59: 180k; R_0603_1608Metric_Pad0.98x0.95mm_HandSolder
R60: 1k; R_0603_1608Metric_Pad0.98x0.95mm_HandSolder

Connections:
+3.3VA: C21.2, C22.1, IC5.1 (VDD); also elsewhere on the board
GNDA: C21.1, C22.2, C23.1, C24.1, C25.1, IC5.4 (AGND), J14.S, R54.1, R56.1; also elsewhere on the board
unnamed: C26.1, IC6.2 (-IN), R58.1, R59.2
unnamed: C26.2, IC6.6 (OUT), R60.2
unnamed: IC5.5 (SPI2C), R54.2
unnamed: J14.T, R59.1, R60.1
VCC: C24.2, IC6.7 (V+); also elsewhere on the board
VEE: C25.2, IC6.4 (V-); also elsewhere on the board
ref_dac4: IC6.3 (+IN), R55.2, R56.2
spi0_cs: IC5.7 (~SYNC/A0), R57.2; also elsewhere on the board
spi0_sck: IC5.6 (SCLK/SCL); also elsewhere on the board
spi0_tx: IC5.8 (SDIN/SDA); also elsewhere on the board
v_out_dac: IC5.2 (VOUT), R58.2
v_ref_dac: C23.2, IC5.10 (VREFIO), R55.1

Notes on the sheet:
-5.2V to 8.4V CHANGE ME! (we probably want something like -2 to 6V)

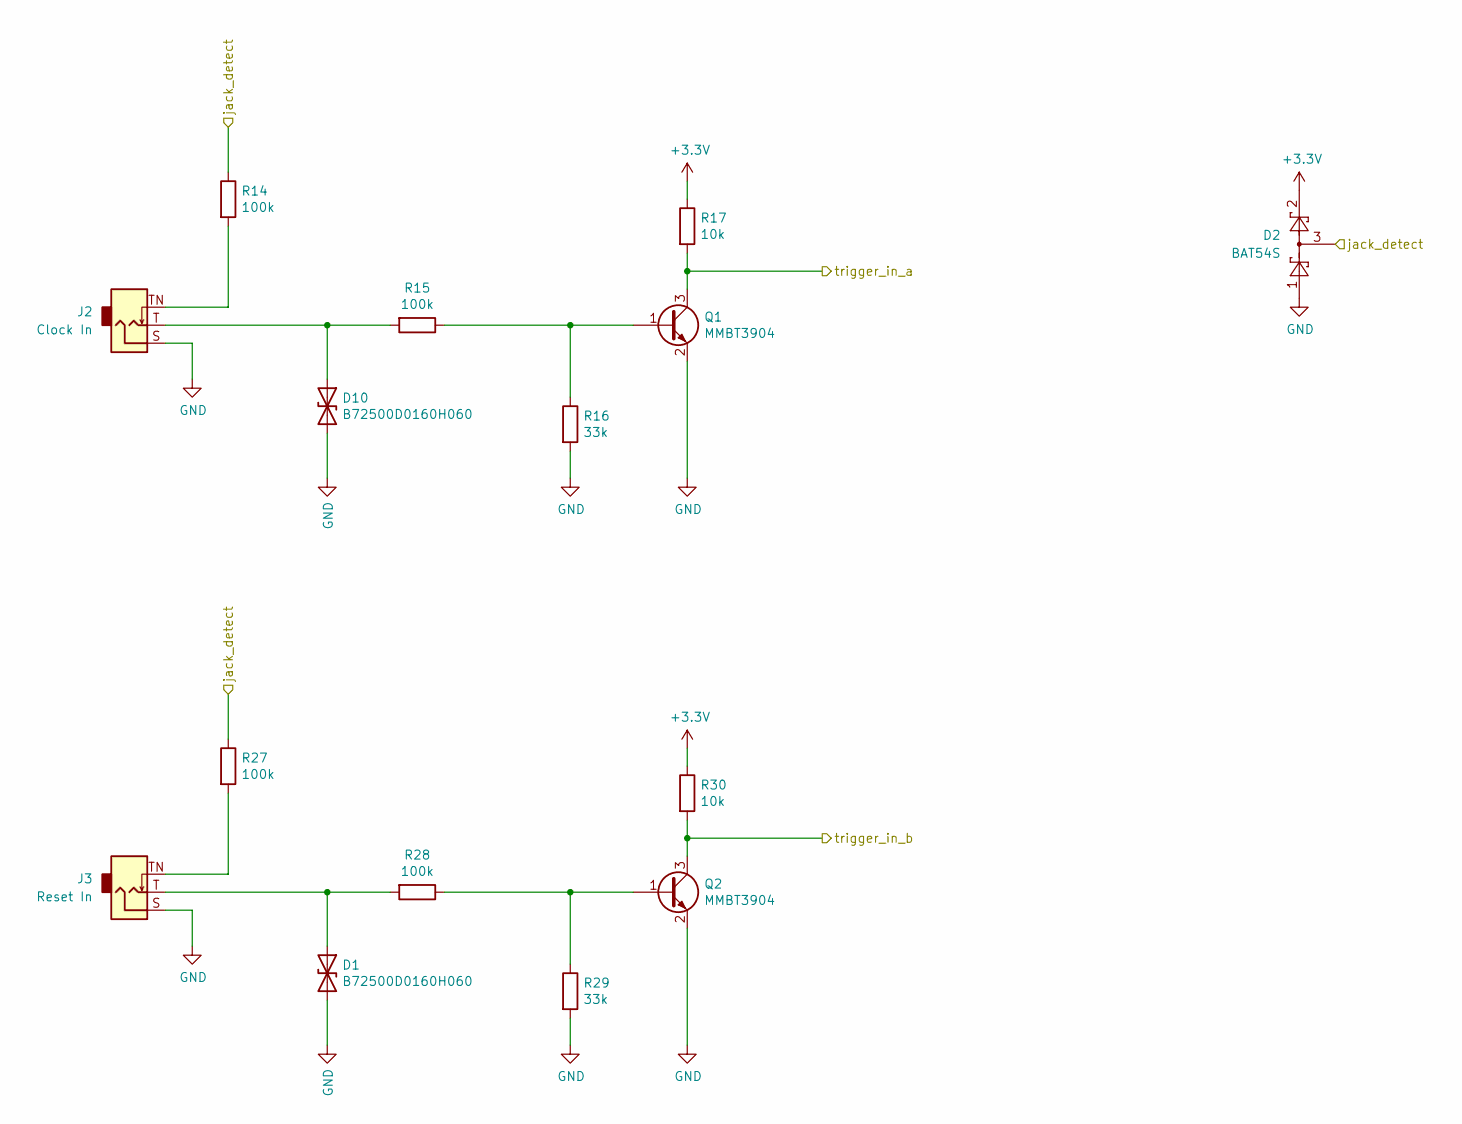
[picture p17: schematic trigger_inputs.kicad_sch]

Parts:
D1, D10: B72500D0160H060; D_0603_1608Metric_Pad1.05x0.95mm_HandSolder
D2: BAT54S; SOT-23_Handsoldering
J2: Clock In; Jack_3.5mm_QingPu_WQP-PJ301BM_Vertical
J3: Reset In; Jack_3.5mm_QingPu_WQP-PJ301BM_Vertical
Q1, Q2: MMBT3904; SOT-23
R14, R15, R27, R28: 100k; R_0603_1608Metric_Pad0.98x0.95mm_HandSolder
R16, R29: 33k; R_0603_1608Metric_Pad0.98x0.95mm_HandSolder
R17, R30: 10k; R_0603_1608Metric_Pad0.98x0.95mm_HandSolder

Connections:
GND: D1.2 (A2), D2.1, D10.2 (A2), J2.S, J3.S, Q1.2 (E), Q2.2 (E), R16.2, R29.2; also elsewhere on the board
unnamed: D1.1 (A1), J3.T, R28.2
unnamed: D10.1 (A1), J2.T, R15.2
unnamed: J2.TN, R14.2
unnamed: J3.TN, R27.2
unnamed: Q1.1 (B), R15.1, R16.1
unnamed: Q2.1 (B), R28.1, R29.1
jack_detect: D2.3, R14.1, R27.1; also elsewhere on the board
trigger_in_a: Q1.3 (C), R17.2; also elsewhere on the board
trigger_in_b: Q2.3 (C), R30.2; also elsewhere on the board

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
Board: 2 copper layers, 166 parts (0 on the bottom side), 128 nets, no tracks yet.

Other parts of the board:
Ref**: Val**; eduquencer-inkscape
