soundslikefrank/eduquencer/(commit log)

2022-01-31 Add blank panel in scad
    [eduquencer.scad]
2022-02-01 create preliminary kicad project
    [cv_input.kicad_sch, dac.kicad_sch, eduquencer.kicad_pcb, eduquencer.kicad_sch, power_ref.kicad_sch]
2022-02-01 add DAC80501MDGST model
    [dac.kicad_sch, eduquencer.kicad_sch]
2022-02-01 Add basic buttons & jacks
    [CUI_DEVICES_TS04-66-73-BK-100-SMT.STL, WQP-PJ398SM.amf, eduquencer.scad]
2022-02-01 Reorder design params
    [eduquencer.scad]
2022-02-01 Add pots & related inputs
    [RD901F-40-15R1.amf, eduquencer.scad]
2022-02-01 Clock in
    [eduquencer.scad]
2022-02-01 rpi module
    [eduquencer.scad]
2022-02-03 add hardware readme with BOM
2022-02-07 switch to debug probe run
2022-02-07 add working SPI example
2022-02-07 add 5/10V voltage references
    [eduquencer.kicad_sch, power_ref.kicad_sch]
2022-02-07 add DAC schematic
    [dac.kicad_sch, eduquencer.kicad_sch]
2022-02-08 not sure what happened. kicad stuff
    [eduquencer.kicad_sch]
2022-02-09 make models portable
    [dac.kicad_sch]
2022-02-10 Outlines instead of 3d models
    [eduquencer.scad]
2022-02-11 add preliminary led circuit
    [eduquencer.kicad_sch, leds.kicad_sch]
2022-02-11 Try python script for designing board
2022-02-16 Buttons in affinity
2022-02-17 Base layout in affinity
    [eduquencer.scad]
2022-02-22 CV in conditioning circuits
    [cv_input.kicad_sch, eduquencer.kicad_sch, leds.kicad_sch]
2022-02-22 Add compensation cap to first cv in
    [cv_input.kicad_sch, eduquencer.kicad_sch]
2022-02-22 Start svg->pcb process
2022-02-22 First attempt at making a panel footprint
2022-02-23 InkScape to PCB working
2022-02-23 Fix footprints edge cuts
2022-02-24 Hardware: LEDs schematics adjustments
    [eduquencer.kicad_sch, leds.kicad_sch]
2022-02-25 Hardware: add button sheet
    [buttons.kicad_sch, eduquencer.kicad_sch, leds.kicad_sch]
2022-02-26 Hardware: add trigger in&outputs, wire rpi
    [buttons.kicad_sch, dac.kicad_sch, eduquencer.kicad_sch, leds.kicad_sch, power_ref.kicad_sch, trigger_inputs.kicad_sch, trigger_outputs.kicad_sch]
2022-02-27 Hardware: add test points, tiny cleanup
    [buttons.kicad_sch, cv_input.kicad_sch, dac.kicad_sch, eduquencer.kicad_sch, leds.kicad_sch, power_ref.kicad_sch, trigger_inputs.kicad_sch, trigger_outputs.kicad_sch]
2022-02-27 Hardware: update models, annotate, fix ERC issues
    [buttons.kicad_sch, cv_input.kicad_sch, dac.kicad_sch, eduquencer.kicad_sch, leds.kicad_sch, power_ref.kicad_sch, trigger_inputs.kicad_sch, trigger_outputs.kicad_sch]
2022-02-27 Hardware: assign all footprints
    [buttons.kicad_sch, cv_input.kicad_sch, dac.kicad_sch, eduquencer.kicad_pcb, eduquencer.kicad_sch, leds.kicad_sch, power_ref.kicad_sch, trigger_inputs.kicad_sch]
2022-03-12 Shift button
2022-03-16 Shift button to design
2022-03-17 Board footprint
2022-03-17 Update board footprint on board
    [eduquencer.kicad_pcb]
